broadcastyourseb/SADR/raspberry/allskySCRIPT/dev/camera/test_demosaiced.jpg

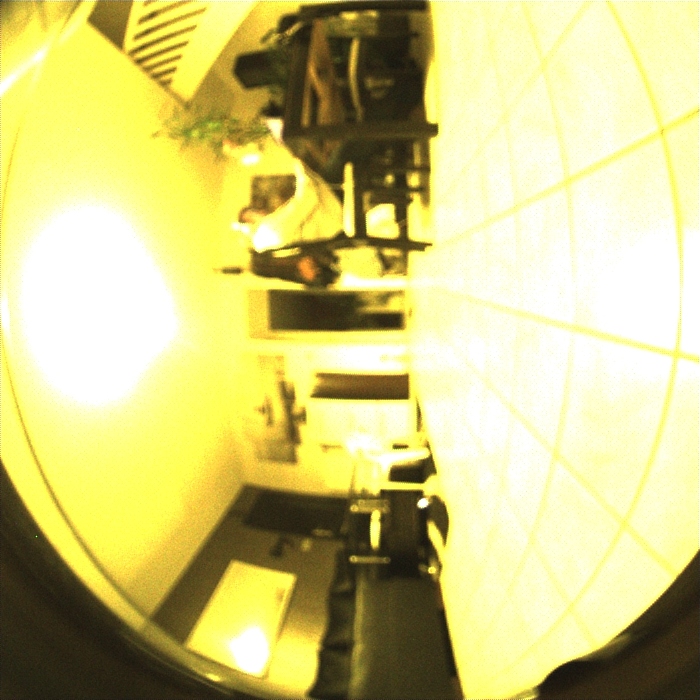
raspberry/allskySCRIPT/dev/camera/test_demosaiced.jpg
