broadcastyourseb/SADR/raspberry/allskySCRIPT/image/allsky.jpg

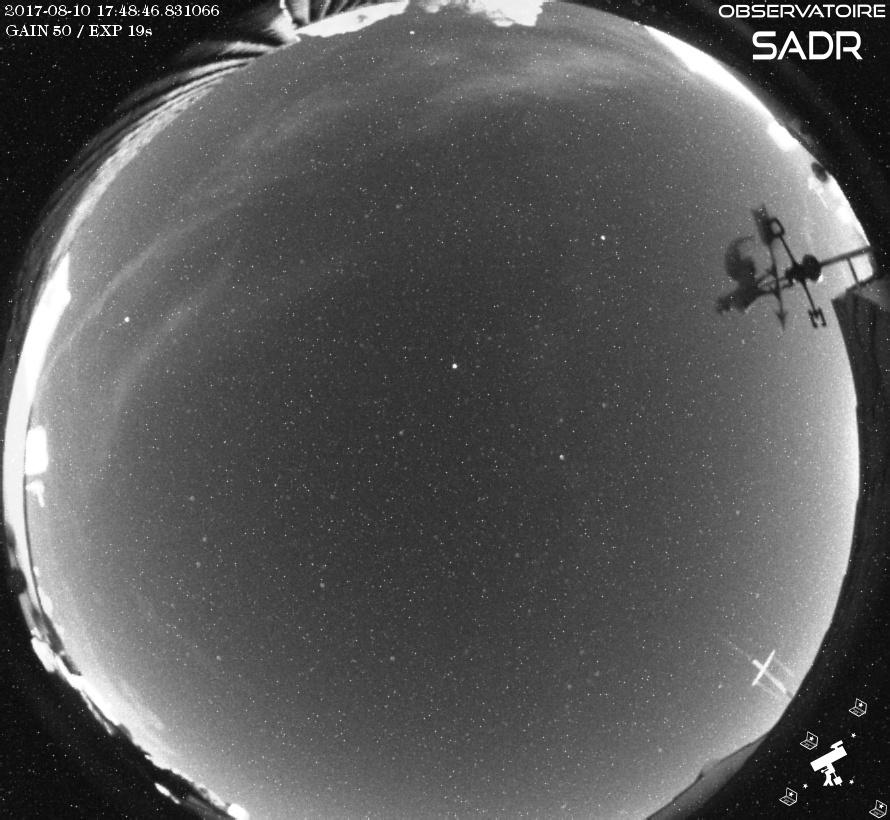
raspberry/allskySCRIPT/image/allsky.jpg
