broadcastyourseb/SADR/README.md

# SADR
All stuff about SADR remote observatory
