broadcastyourseb/SADR/doc/SkyTemperatureModel.pdf

## Sky Temperature Correction Model

The model to correct the sky temperature measured by the infrared sensor (Ts) is given in terms of the ambient temperature (Ta) by:

Td = (K1 / 100) * (Ta - K2 / 10) + (K3 / 100) * (Exp (K4 / 1000* Ta)) ^ (K5 / 100)

where | Td = Correction value (ºC) Ta = Ambient temperature ( ºC) K1, K2, K3, K4 & K5 are the coefficients defined in the Device section of the Setup TAB
| Exp(n)= e (the base of natural logarithms) raised to the power of n. a^b = a raised to the power of b

The corrected sky temperature (Tsky) is given by:

Tsky = Ts – Td

where Tsky = Corrected Sky Temperature (ºC) Ts = Infrared Sky Measured Temperature (ºC) Td = Correction value (ºC)
