broadcastyourseb/SADR/arduino/Schema_platine_meteo.png

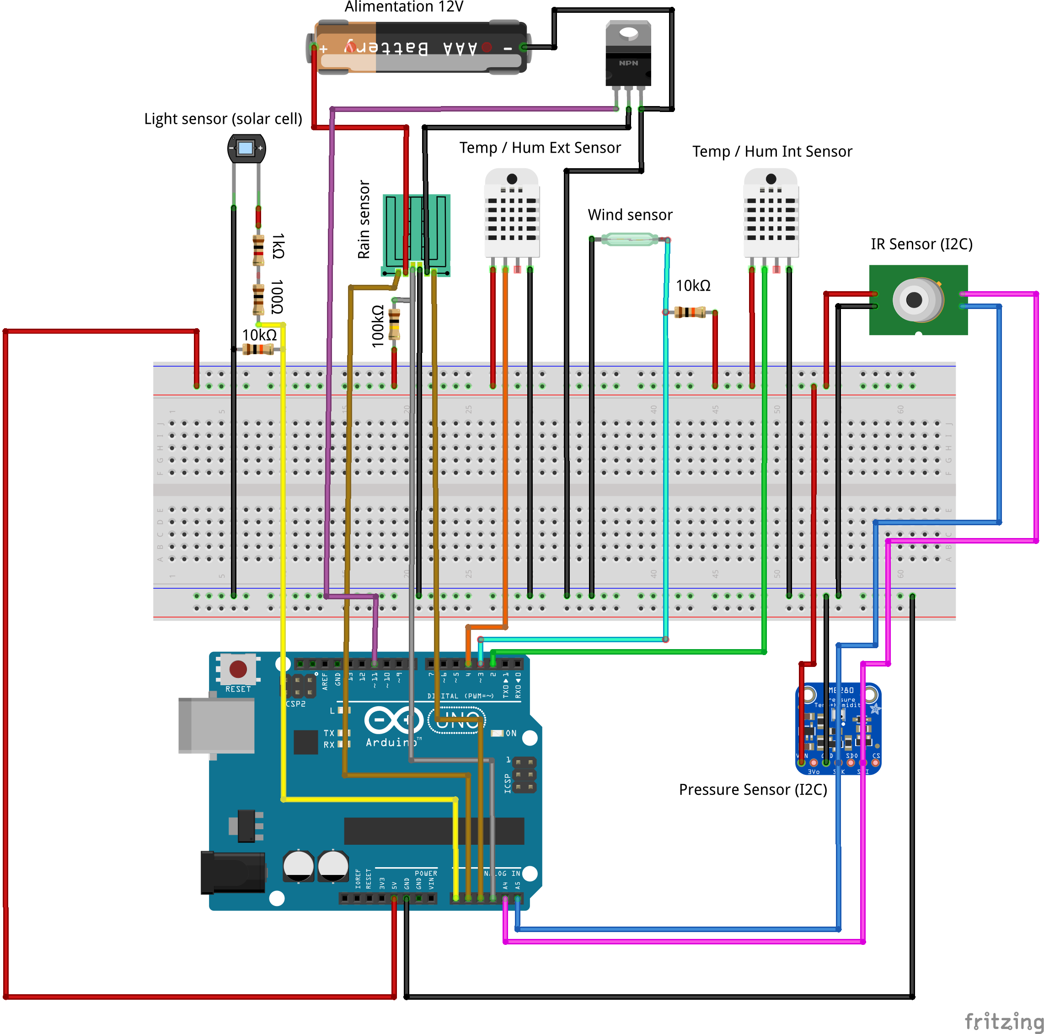
arduino/Schema_platine_meteo.png
