broadcastyourseb/SADR/doc/allsky_seb2.jpg

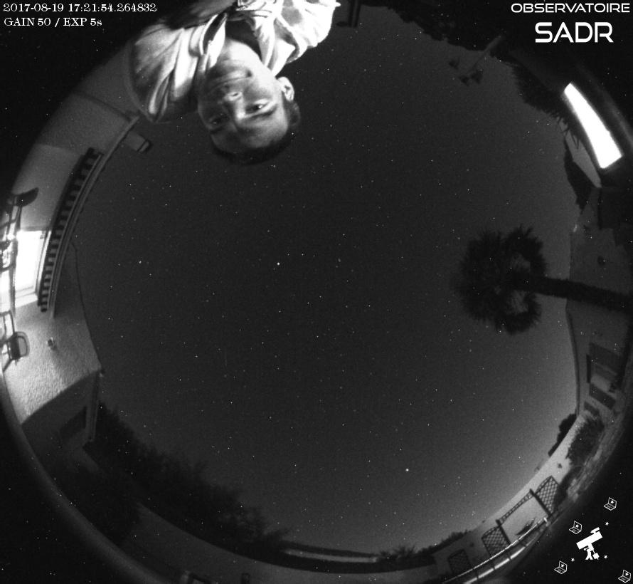
doc/allsky_seb2.jpg
