broadcastyourseb/SADR/doc/allsky_seb.jpg

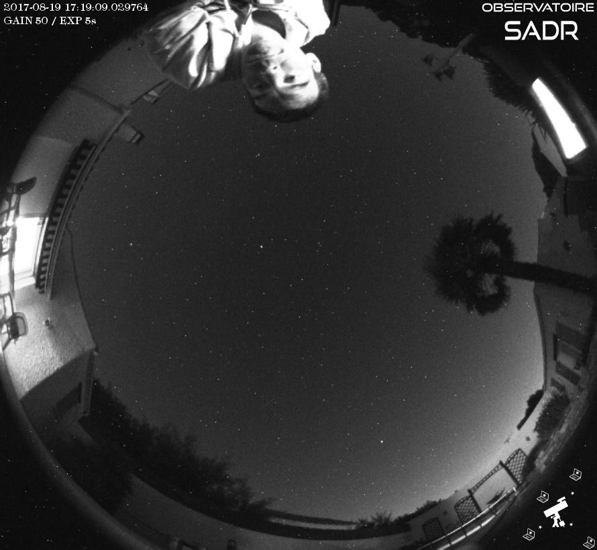
doc/allsky_seb.jpg
