broadcastyourseb/SADR/raspberry/allskySCRIPT/dev/allsky.jpg

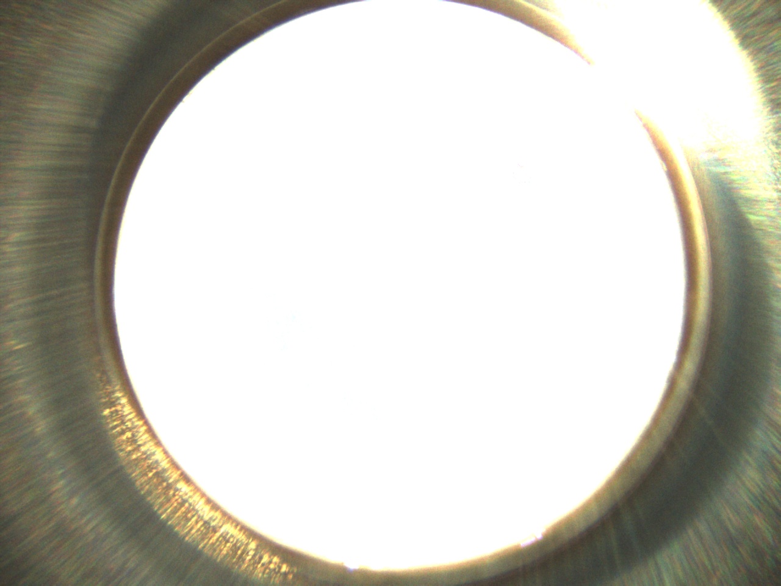
raspberry/allskySCRIPT/dev/allsky.jpg
