broadcastyourseb/SADR/raspberry/allskySCRIPT/dev/camera/output.jpg

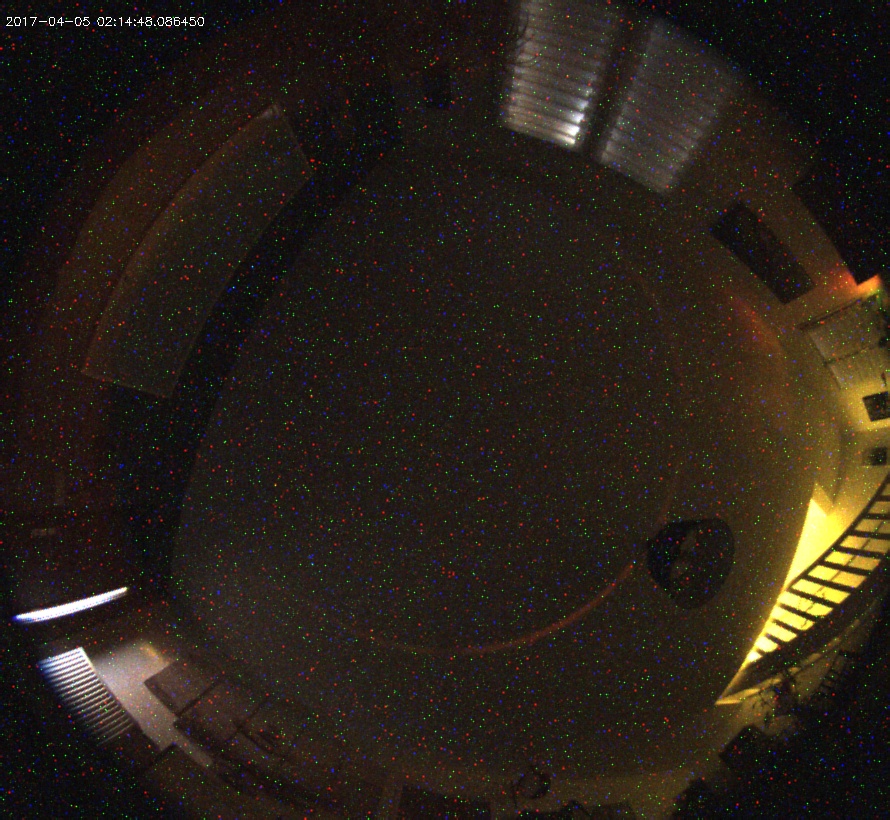
raspberry/allskySCRIPT/dev/camera/output.jpg
