broadcastyourseb/SADR/raspberry/allskySCRIPT/dev/camera/white balance/left.jpg

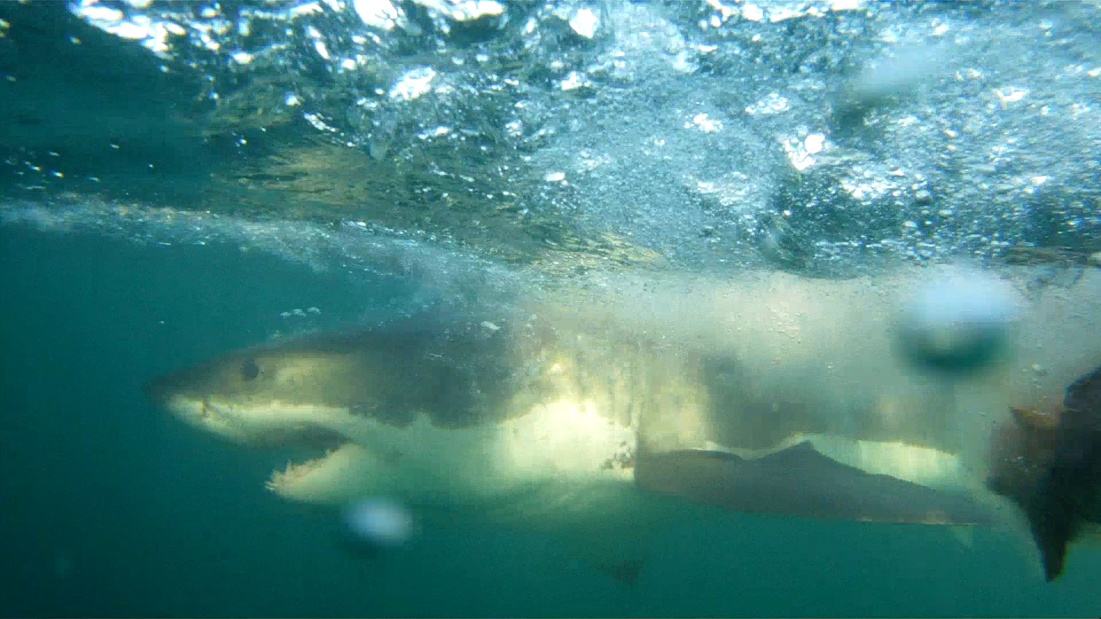
raspberry/allskySCRIPT/dev/camera/white balance/left.jpg
