broadcastyourseb/SADR/raspberry/allskySCRIPT/dev/camera/white balance/right.jpg

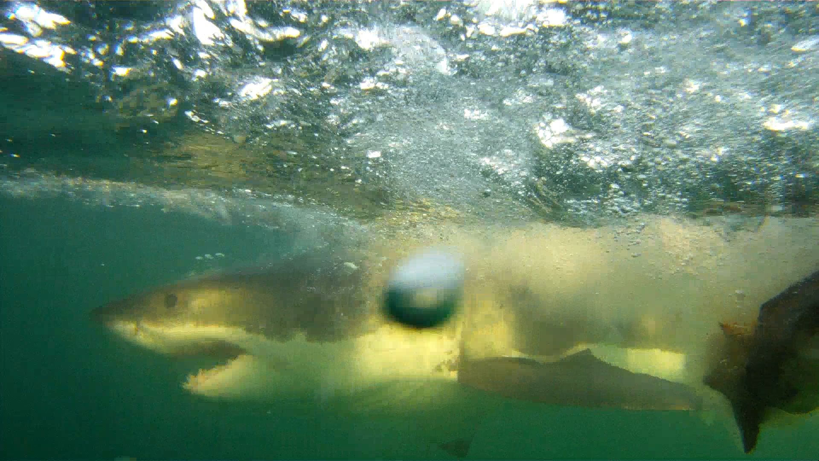
raspberry/allskySCRIPT/dev/camera/white balance/right.jpg
