broadcastyourseb/SADR/raspberry/allskySCRIPT/dev/offset/input_nb.jpg

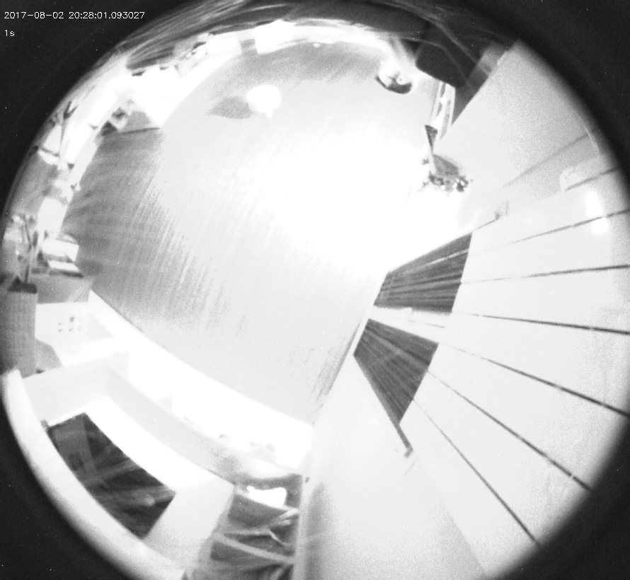
raspberry/allskySCRIPT/dev/offset/input_nb.jpg
