broadcastyourseb/SADR/raspberry/allskySCRIPT/dev/watermark/watermark_option1.png

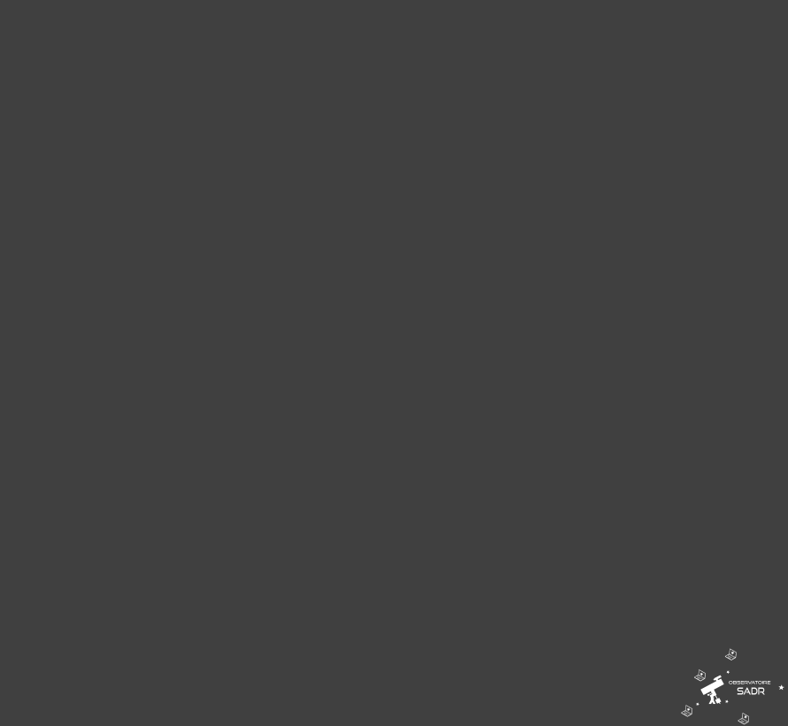
raspberry/allskySCRIPT/dev/watermark/watermark_option1.png
