broadcastyourseb/SADR/raspberry/allskySCRIPT/dev/watermark/watermark_option2.png

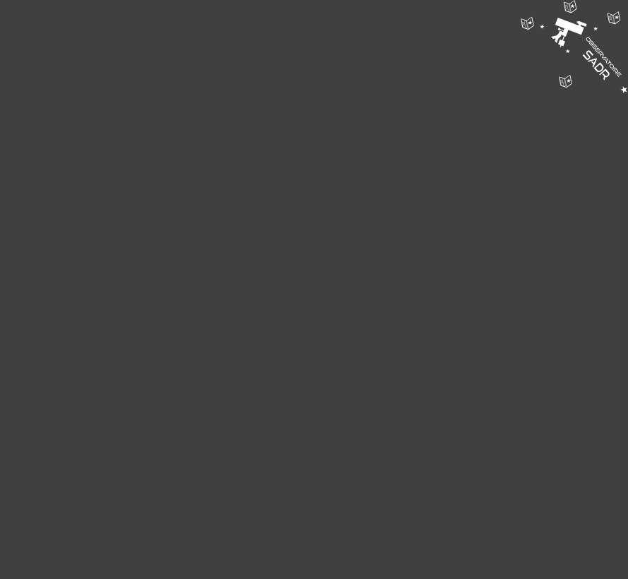
raspberry/allskySCRIPT/dev/watermark/watermark_option2.png
