broadcastyourseb/SADR/raspberry/allskyWEB/images/allskytemp.jpg

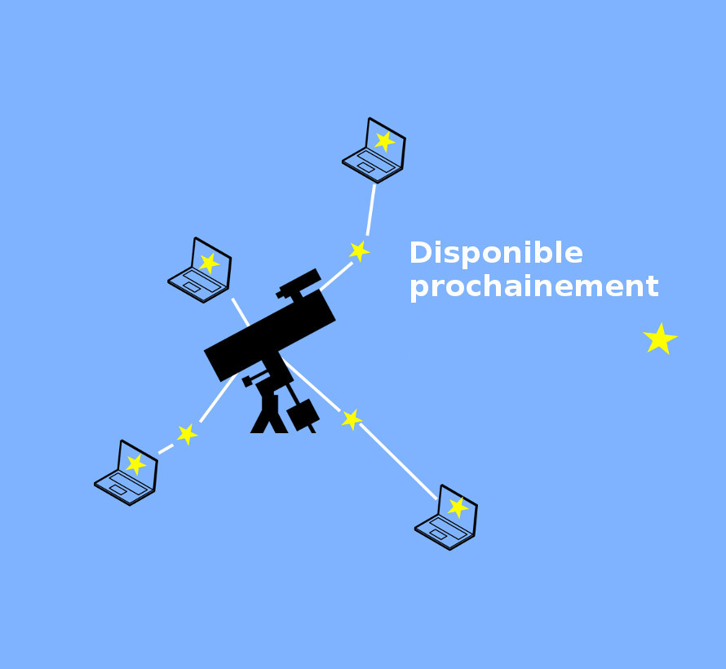
raspberry/allskyWEB/images/allskytemp.jpg
