broadcastyourseb/SADR/raspberry/allskyWEB/images/zoom.jpg

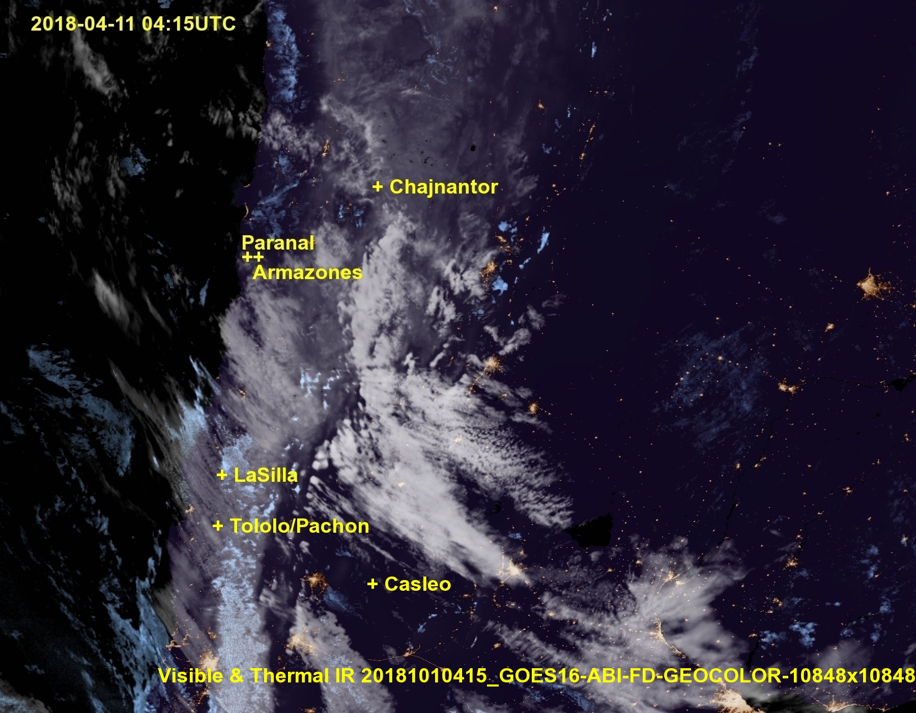
raspberry/allskyWEB/images/zoom.jpg
