broadcastyourseb/SADR/boitier/Allsky.fcstd

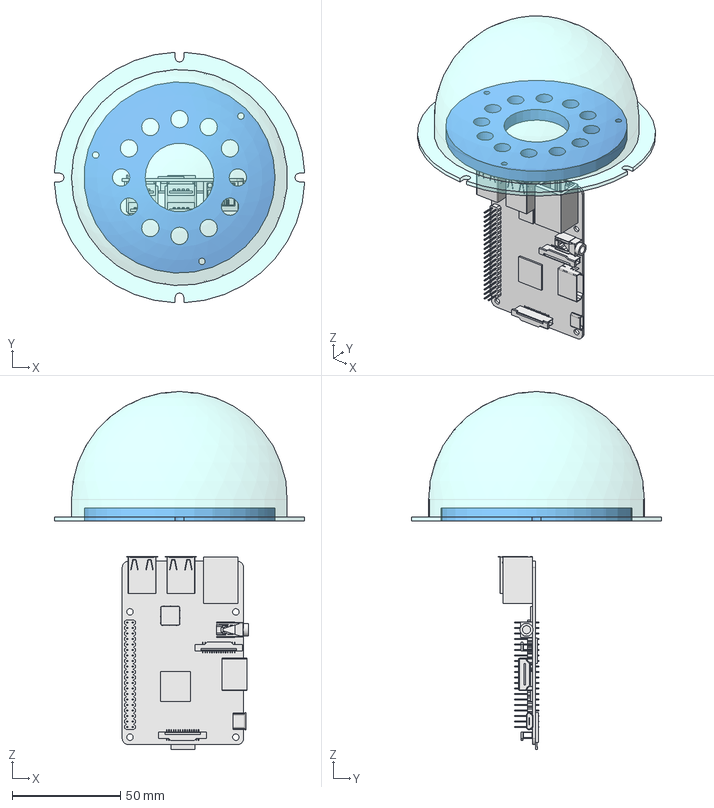
[picture p22: CAD file, 2017-07-06]
boitier/Allsky.fcstd
115.9 x 115.9 x 165.7 mm
PolarPattern002
Dome001
RaspberryPi2
RaspberryPi003
RaspberryPi004
RaspberryPi005
RaspberryPi006
RaspberryPi007
RaspberryPi008
RaspberryPi009
RaspberryPi010
CameraAssembly
CameraAssembly001
CameraAssembly002
CameraAssembly003
RaspberryPi011
RaspberryPi012
RaspberryPi013
RaspberryPi014
RaspberryPi015
RaspberryPi016
RaspberryPi017
RaspberryPi018
RaspberryPi019
RaspberryPi020
RaspberryPi021
