broadcastyourseb/SADR/boitier/dome.fcstd

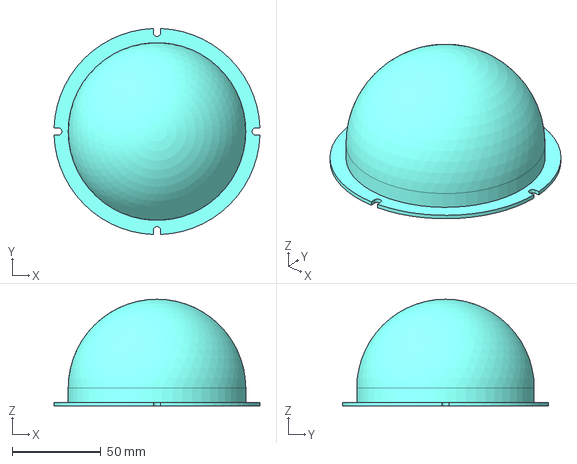
[picture p23: CAD file, 2017-07-06]
boitier/dome.fcstd
115.9 x 115.9 x 60.0 mm
