broadcastyourseb/SADR/arduino/test_sensor/Wind_sensor/wind_math.ods

41 | ms | = | 0,5 | tour
0,041 | s
0,0006833333 | min | = | 0,5 | tour
1 | min | = | 731,7073170732 | RPM
 |  | = | 29,2682926829 | km/h
vitesse vent
formule
WindSpeed = (reedSwitchCount-1) * 30000 / SERIAL_DELAY / WIND_RPM_TO_KMH;
vitesse vent | 7,61 | km/h | nombre | 64
vitesse vent | 190,25 | rpm | vitesse vent | 189 | rpm
nombre | 64,4166666667 |  | vitesse vent | 7,56 | km/h
