broadcastyourseb/SADR/arduino/test_sensor/Rain_sensor/PID_Finder/PID.ods

temps | T | PID | diff | Source : | http://www.rhaaa.fr/regulation-pid-comment-la-regler-12
11921 | 19,73 | 10 |  | DeltaT | 42,44 | °C
12035 | 19,75 | 10 | 114 | DetaPower | 190 | unité
12148 | 19,73 | 10 | 113
12262 | 19,74 | 10 | 114 | Kp | 0,223 | °C/unité
12376 | 19,74 | 10 | 114
12489 | 19,75 | 10 | 113
12603 | 19,74 | 10 | 114 | 63,00% | 46,4572 | °C
12717 | 19,73 | 10 | 114 | t0% | 60425 | ms
12830 | 19,72 | 10 | 113 | t63% | 195412 | ms
12944 | 19,74 | 10 | 114 | Tp | 134,987 | s
13058 | 19,75 | 10 | 114
13171 | 19,74 | 10 | 113 | Op | 0,329 | s
13284 | 19,75 | 10 | 113
13398 | 19,74 | 10 | 114
13511 | 19,72 | 10 | 113 | Modéré |  |  | Agressif
13625 | 19,72 | 10 | 114 | 1Tp | 134,987 |  | 0.1Tp | 13,4987
13739 | 19,73 | 10 | 114 | 8Op | 2,632 |  | 0.8Op | 0,2632
13852 | 19,72 | 10 | 113
13966 | 19,73 | 10 | 114
14080 | 19,74 | 10 | 114 | Tc | 134,987 |  | Tc | 13,4987
14193 | 19,72 | 10 | 113
14307 | 19,75 | 10 | 114 | Kc | 4,4660236636 |  | Kc | 43,7039028948
14420 | 19,74 | 10 | 113 | Ti | 134,987 |  | Ti | 134,987
14534 | 19,72 | 10 | 114 | Td | 0,1642997784 |  | Td | 0,1642997784
14648 | 19,74 | 10 | 114
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
