broadcastyourseb/SADR/(threads)

Thread 5 (2017-08-07):

Fix low temperature regulation of rain sensor

broadcastyourseb, 2017-08-07:
Happens when global temperature is above the low temperature regulation
When the sensor is cooling and relative humidity is high, sensor capacity is rising and system believe it's raining..

broadcastyourseb, 2017-08-10:
Rewrite the regulation program

Closed 2017-08-10.

Thread 9 (2017-08-07):

Change the threshold of rain temperature regulation

broadcastyourseb, 2017-08-07:
Actually displays 2 green areas with 25° and 50°C temperature.

broadcastyourseb, 2017-08-07:
Resolve by adding the method "setSection" in the update function

Closed 2017-08-07.

Thread 10 (2017-08-13):

Avoid NaN value serial sent by arduino

broadcastyourseb, 2017-08-13:
In order to avoid pike with RRD graph

Closed 2017-08-14.

Thread 11 (2017-08-13):

Broadcast UDP

broadcastyourseb, 2017-08-13:
s'agissant de la all sky, il faudrait qu'on aie un driver de station météo pour être capable de récupérer les alertes (pluie / vent).

On a largement le temps de développer cette fonction, on en a pas forcément besoin au début, mais on peut commencer à y réfléchir.

Idéalement, il faudrait que la all sky diffuse en broadcast UDP un statut de la situation. Le code de statut peut être simple : observation OK, ou observation NOK.

Voir ici comment ça fonctionne dans visual studio (je pourrai m'inspirer de ce code pour développer le driver)

https://docs.microsoft.com/en-us/dotnet/framework/network-programming/using-udp-services
