broadcastyourseb/SADR/(list of files, drawings)

Other design files:
arduino/fritzing/Schema_platine_meteo.fzz
