broadcastyourseb/SADR/raspberry/allskySCRIPT/sounding.py

#!/usr/bin/python
#-*- coding: iso-8859-15 -*-
# INDUINO METEOSTATION
# http://induino.wordpress.com 
# 
# NACHO MAS 2013

import urllib
import tidy
import datetime,time
import locale
from PIL import Image
from string import upper 
from meteollskyconfig import *


class uwyoClass:
    YEAR=""
    MONTH=""
    FROM=""
    def __init__(self):
        pass

    def __init__(self,date_time):
	self.set_date(date_time)

    def set_date(self,date_time):
        self.YEAR=datetime.datetime.strftime(date_time,"%Y")
        self.MONTH=datetime.datetime.strftime(date_time,"%m")
        if (date_time.hour >13):
	        self.FROM=datetime.datetime.strftime(date_time,"%d")+"12"
	else:
	        self.FROM=datetime.datetime.strftime(date_time,"%d")+"00"
	print self.YEAR,self.MONTH,self.FROM
	

    def get_sounding_skewt(self):
        data=urllib.urlencode({"region":"europe","TYPE":"GIF:SKEWT","YEAR":self.YEAR,"MONTH":self.MONTH,"FROM":self.FROM,"TO":self.FROM,"STNM":SOUNDINGSTATION})
        #print data
        s = urllib.urlopen("http://weather.uwyo.edu/cgi-bin/sounding?",data)
        o=s.read()
        s.close()
        document=tidy.parseString(o)    
        urllib.urlretrieve("http://weather.uwyo.edu/upperair/images/"+self.YEAR+self.MONTH+self.FROM+".08221.skewt.gif", CHARTPATH+"skewt.gif")
        #print document

    def get_sounding_data(self):
        data=urllib.urlencode({"region":"europe","TYPE":"TEXT:LIST","YEAR":self.YEAR,"MONTH":self.MONTH,"FROM":self.FROM,"TO":self.FROM,"STNM":SOUNDINGSTATION})
        #print data
        s = urllib.urlopen("http://weather.uwyo.edu/cgi-bin/sounding?",data)
        o=s.read()
        s.close()
        document=tidy.parseString(o)    
        fi=open(CHARTPATH+"sounding.html","w")
        fi.write(str(document))
        fi.close()

if __name__=='__main__':
   print "Starting internet data downloader"
   #try:
 	#print "Retriving SKEW-T diagrams from:",SOUNDINGSTATION
   #except:
	#print "NO sounding station define in meteoconfig.py"
	#exit(0)

   while (True):
        #today=datetime.datetime.utcnow()
        #s=uwyoClass(today)
	try:
	        #s.get_sounding_skewt()
        	#s.get_sounding_data()
		#urllib.urlretrieve(EUMETSAT_LAST, CHARTPATH+"meteosat.jpg")
                urllib.urlretrieve("https://www.gemini.edu/sciops/telescopes-and-sites/weather/cerro-pachon/cameras/img.png", CHARTPATH+"allsky_gemini.png")
                im = Image.open(CHARTPATH+"allsky_gemini.png")
                im.save(CHARTPATH+"allsky_gemini.jpg")
	except:
		print "Fail to retrive internet data"
	#del s
	time.sleep(600)
