broadcastyourseb/SADR/(commit log)

2017-07-04 ajout des tests des capteurs
2017-07-06 ajout cablage platine meteo
    [Allsky.fcstd, Schema_platine_meteo.fzz, dome.fcstd]
2017-07-13 ajout partie firmata arduino
    [gphoto2-config.txt, gphoto2-port-config.txt]
2017-07-18 customisation firmware arduino
2017-07-19 light function in arduino firmware
2017-07-20 adding pressure sensor to the arduino firmware
2017-07-21 modify library firmware arduino
2017-07-21 adding ir sensor to arduino firmware
2017-07-24 new firmware arduino and makefile
2017-07-25 firmware arduino
2017-07-25 new firmware arduino
2017-07-26 new firmware with no working rain sensor
2017-07-29 cleaning directory
    [gphoto2-config.txt, gphoto2-port-config.txt]
2017-07-30 cleaning arduino directory
2017-07-30 all Makefile working on raspberry
2017-07-30 adapt createRRD file to SADR sensor
2017-07-31 fix bug in startMETEOLLSKY.sh
    [meteollskyconfig.py]
2017-07-31 fix indentation in py file
    [meteoRRD_graph.py, meteoRRD_updater.py]
2017-07-31 arduino firmware modify to adapt the output sentence with :
2017-07-31 test arduino output sentence
2017-08-01 issue with lineread function of the serial class
    [meteoRRD_updater.py, sadr_meteo_no_firmata.ino]
2017-08-02 fix device port bug + adding waermark to allsky frame
    [allsky_frame.py, meteollskyconfig.py]
2017-08-03 working on allsky frame
2017-08-04 fix bug with allsky script
    [allsky_frame.py, meteollskyconfig.py]
2017-08-04 change top position of time on allsky frame
2017-08-04 change reference temperature sensor
2017-08-04 fix updater with json file
    [meteoRRD_updater.py]
2017-08-05 fixing and adding MaxMinAvg script
    [meteoRRD_MaxMinAvg.py]
2017-08-05 fix bad name in updater script
    [meteoRRD_createRRD.py, meteoRRD_updater.py]
2017-08-05 adding wind and rain led on meteostation web
2017-08-05 change iradiance scale and adding daylight LED
2017-08-06 adding sensor on steelGAuge web page
    [Validation.ods]
2017-08-06 rename and finish measures.html webpage
    [Validation.ods]
2017-08-07 liste bug + modification seuil d'alarme web pour coincider avec seuil arduino
    [Validation.ods]
2017-08-07 try to fix issue #6 Display on smartphone of webpage measures.html
    [Validation.ods]
2017-08-07 try to fix issue #9 Change the threshold of rain temperature regulation
2017-08-08 adding new feature to firmare arduino wind calculation + regul t° rain sensor
2017-08-11 fix issue #3 and issue #7
    [meteoRRD_MaxMinAvg.py, meteoRRD_graph.py, meteoRRD_updater.py, sadr_meteo_no_firmata.ino]
2017-08-13 finish web page related to allsky frame and rrd graph + starting pushetta improvment
2017-08-14 fine tune of rain sensor PID
    [PID.ods]
2017-08-19 web page improvment with iframe + bug rain sensor measure
    [meteoRRD_graph.py, meteoRRD_updater.py, sadr_meteo_no_firmata.ino]
2017-08-19 fixed no refreshing led left panel + working on allsky frame script
    [allsky_frame.py, meteoRRD_updater.py, meteollskyconfig.py]
2017-10-28 change pressure formule for RRD graph
2017-10-29 fix humidity error measure
    [StateChangeDetection.ino, Wind_sensor.ino, sadr_meteo_no_firmata.ino]
2017-10-29 change wind sensor firmware test
    [Allsky.fcstd, PID.ods, Schema_platine_meteo.fzz, dome.fcstd]
2017-10-29 change wind sensor test
2018-02-28 fix bug maxwind speed < mean wind speed
    [sadr_meteo_no_firmata.ino]
2018-03-02 fix max wind error
    [sadr_meteo_no_firmata.ino]
2018-03-02 fix error in mean wind speed measurement
    [sadr_meteo_no_firmata.ino]
2018-03-02 fix bug with pid tune
    [sadr_meteo_no_firmata.ino]
2018-03-04 adding 2 cases for the allsky camera exposure
2018-03-04 fix luminosity = 0 to ==0
    [allsky_frame.py]
2018-03-04 some fix in allsky exposure script
    [allsky_frame.py]
2018-03-04 add luminosity info in allsky frame
2018-03-04 fix luminosity strange character in frame
    [allsky_frame.py]
2018-03-04 add a third step for exposure frame
2018-03-04 fix exposure frame
2018-03-05 improvment with exposure frame
2018-03-05 add USB_TRAFFIC parameter to allsky frame script
2018-03-08 adding analog read of temperature rain sensor
2018-03-11 fix rain temperature failure with PID
    [sadr_meteo_no_firmata.ino]
2018-03-15 adding wind math
    [wind_math.ods]
2018-03-15 adding mean value to the frame
2018-03-15 fx error with mean string
    [allsky_frame.py]
2018-04-10 change cloud temperature limit detection
2018-04-10 adding allsky gemini and change sadr allsky with temp frame
2018-04-10 add gemini frame in allinone.html
2018-04-11 add logo sadr on all ESO frame
2018-04-11 adding ESO frame title
2018-04-11 center title on ESO frame
2018-05-01 change order between area and line with light graph to fix overlap trouble
    [meteoRRD_graph.py]
2018-05-01 minor fix with rrd graph
    [meteoRRD_graph.py]
2018-05-01 save allsky gemini frame to usb stick to increase load speed
2018-05-02 fix library link with sounding.py
    [meteoRRD_graph.py, sounding.py]
2018-05-02 fix error save path jpg file
    [sounding.py]
2018-05-10 rename variable to avoid mistake
    [sadr_meteo_no_firmata.ino]
2018-05-10 decrease cold temperature from 25 to 10
2018-05-10 adding debug print comment in python code
2018-05-10 fix isFlag string/float value
    [meteoRRD_updater.py]
2018-05-10 change Temp Rain min value with dial and change arduino code to have +10°C of ambiant T°
